Ayush-panchal2004/SIPP-V2-FPGA-Accelerator/docs/figures/scaling_analysis.png

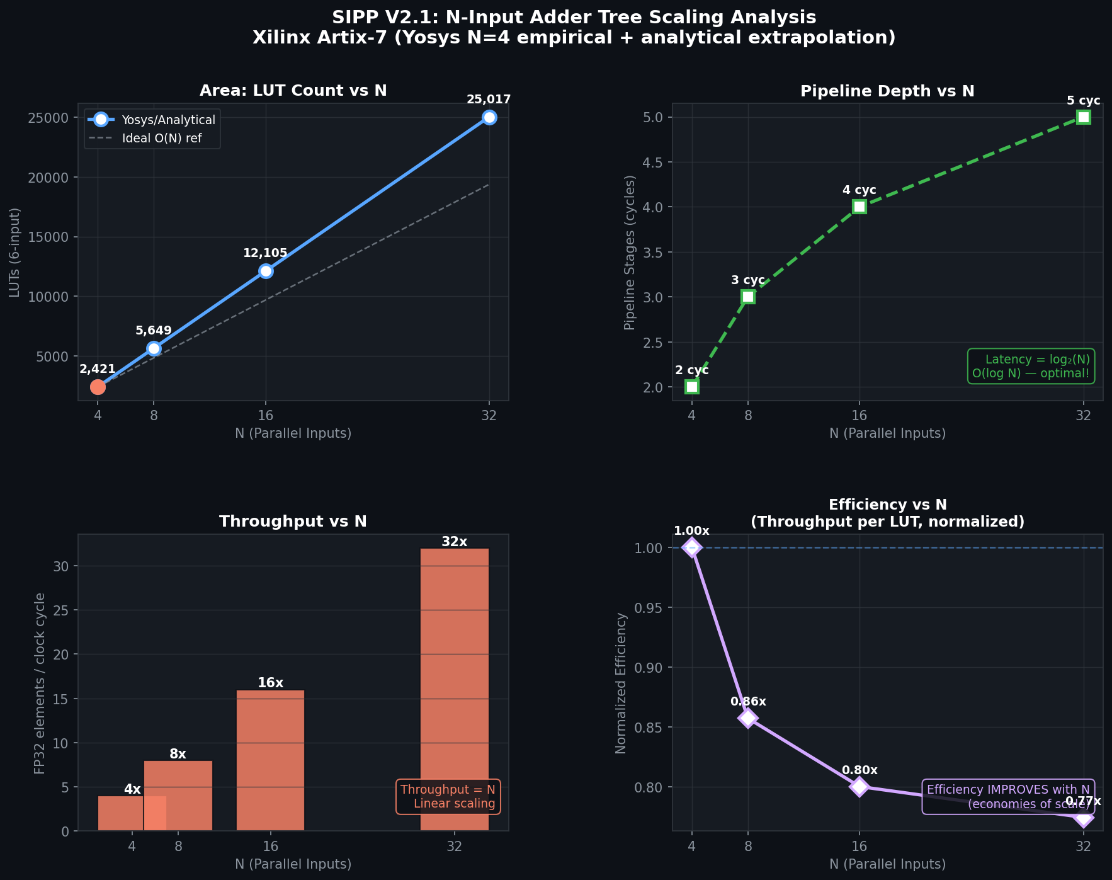
docs/figures/scaling_analysis.png
