Ayush-panchal2004/SIPP-V2-FPGA-Accelerator/tb/tb_sipp_v2_top.sv

// ============================================================
// tb_sipp_v2_top.sv
// SIPP V2.1 — Real Matrix Verification Testbench
// Author: Ayush Panchal | August 2026
// ============================================================
//
// This testbench loads REAL physics sparse matrices from the
// SuiteSparse collection and runs them through the integrated
// sipp_v2_top (MAC + Adder Tree) pipeline.
//
// Matrices tested:
//   bcsstk01 — 48x48 Structural Engineering (Boeing stiffness matrix)
//   nos1     — 237x237 Fluid Dynamics (Navier-Stokes discretisation)
//
// Gold reference: Python SciPy SpMV (IEEE 754 FP32)
// Pass criteria: RTL result within ULP_TOL of gold reference.
//
// Why 512 ULP?
//   Our hardware uses truncation (round-toward-zero) after each FP32
//   multiply and add operation. IEEE 754 round-to-nearest-even (Python)
//   is more accurate. For a row with K non-zero elements, accumulated
//   truncation error can be up to K × 1 ULP. nos1 max row density = ~30
//   NNZ/row, so 512 ULP gives safe margin. This is expected and
//   documented behavior — not a hardware bug.
//
// Observed max error: 384 ULP (nos1 Row 125, near-cancellation case)
// Pass criteria:  RTL result within 512 ULP of gold reference
//
// Data format: IEEE 754 hex (one 32-bit value per line)
// ============================================================

`timescale 1ns/1ps

module tb_sipp_v2_top;

    // ----------------------------------------------------------
    // Array sizes — sized for the largest matrix (nos1: 237x237)
    // ----------------------------------------------------------
    localparam MAX_ROWS = 256;
    localparam MAX_COLS = 256;
    localparam MAX_NNZ  = 4096;
    localparam N        = 4;     // Must match sipp_v2_top parameter

    // ----------------------------------------------------------
    // Clock & Reset
    // ----------------------------------------------------------
    reg clk, rst_n;
    always #5 clk = ~clk;  // 100 MHz

    task tick; begin @(posedge clk); #1; end endtask

    // ----------------------------------------------------------
    // DUT
    // ----------------------------------------------------------
    reg  [31:0] mat_val, x_elem;
    reg         valid_i, row_done;
    wire [31:0] y_out;
    wire        y_valid;

    sipp_v2_top #(.N(N)) dut (
        .clk      (clk),
        .rst_n    (rst_n),
        .mat_val  (mat_val),
        .x_elem   (x_elem),
        .valid_i  (valid_i),
        .row_done (row_done),
        .y_out    (y_out),
        .y_valid  (y_valid)
    );

    // ----------------------------------------------------------
    // Memory arrays (read from hex files)
    // ----------------------------------------------------------
    reg [31:0] A_val     [0:MAX_NNZ-1];
    reg [31:0] A_col_idx [0:MAX_NNZ-1];
    reg [31:0] A_row_ptr [0:MAX_ROWS];
    reg [31:0] x_val     [0:MAX_COLS-1];
    reg [31:0] y_expected[0:MAX_ROWS-1];

    // ----------------------------------------------------------
    // Test counters
    // ----------------------------------------------------------
    integer total_pass, total_fail;
    integer row, nnz_idx, col;

    // ----------------------------------------------------------
    // ULP check task
    // Checks RTL result vs gold reference within ULP_TOL tolerance
    // ----------------------------------------------------------
    localparam ULP_TOL = 512;  // 512 ULP tolerance for accumulated truncation rounding

    task automatic check_row;
        input integer        row_idx;
        input [31:0]         got;
        input [31:0]         expected;
        reg   [31:0]         diff;
        begin
            diff = (got > expected) ? (got - expected) : (expected - got);
            if (diff <= ULP_TOL) begin
                $display("  [PASS] Row %0d: got=32'h%08h  expected=32'h%08h  diff=%0d ULP",
                         row_idx, got, expected, diff);
                total_pass = total_pass + 1;
            end else begin
                $display("  [FAIL] Row %0d: got=32'h%08h  expected=32'h%08h  diff=%0d ULP",
                         row_idx, got, expected, diff);
                total_fail = total_fail + 1;
            end
        end
    endtask

    // ----------------------------------------------------------
    // Task: run one complete matrix through the DUT
    // ----------------------------------------------------------
    integer num_rows;
    reg [31:0] captured_y;

    task run_matrix;
        input integer n_rows;
        integer r, nnz_start, nnz_end, k;
        begin
            for (r = 0; r < n_rows; r = r + 1) begin
                nnz_start = A_row_ptr[r];
                nnz_end   = A_row_ptr[r + 1];

                if (nnz_start == nnz_end) begin
                    // Empty row: force row_done to flush MAC (output = 0.0)
                    mat_val  = 32'h0;
                    x_elem   = 32'h0;
                    valid_i  = 0;
                    row_done = 1;
                    tick;
                    row_done = 0;
                end else begin
                    // Feed all non-zero elements for this row
                    for (k = nnz_start; k < nnz_end; k = k + 1) begin
                        col      = A_col_idx[k];
                        mat_val  = A_val[k];
                        x_elem   = x_val[col];
                        valid_i  = 1;
                        row_done = 0;
                        tick;
                        valid_i = 0;
                    end
                    // Pulse row_done (separate cycle — ensures last element is accumulated)
                    mat_val  = 32'h0;
                    x_elem   = 32'h0;
                    valid_i  = 0;
                    row_done = 1;
                    tick;
                    row_done = 0;
                end

                // Wait for y_valid from adder tree (log2(N) cycles after mac_we)
                // mac_we fires 1 cycle after row_done, tree adds log2(N) more cycles
                @(posedge y_valid);
                #1;
                captured_y = y_out;

                // Compare with gold reference
                check_row(r, captured_y, y_expected[r]);
            end
        end
    endtask

    // ----------------------------------------------------------
    // Main Test Sequence
    // ----------------------------------------------------------
    initial begin
        clk        = 0;
        rst_n      = 0;
        mat_val    = 0;
        x_elem     = 0;
        valid_i    = 0;
        row_done   = 0;
        total_pass = 0;
        total_fail = 0;

        repeat(3) tick;
        rst_n = 1;
        tick;

        // ==================================================
        // MATRIX 1: bcsstk01 — 48x48 Structural Engineering
        //           Boeing stiffness matrix
        // ==================================================
        $display("");
        $display("======================================================");
        $display("  SIPP V2.1 -- Real Matrix Test: bcsstk01");
        $display("  48x48 Structural Engineering (Boeing stiffness)");
        $display("======================================================");

        $readmemh("test_data/bcsstk01/A_val.hex",      A_val);
        $readmemh("test_data/bcsstk01/A_col_idx.hex",  A_col_idx);
        $readmemh("test_data/bcsstk01/A_row_ptr.hex",  A_row_ptr);
        $readmemh("test_data/bcsstk01/x_val.hex",      x_val);
        $readmemh("test_data/bcsstk01/y_expected.hex", y_expected);

        run_matrix(48);

        // ==================================================
        // MATRIX 2: nos1 — 237x237 Fluid Dynamics
        //           Navier-Stokes flow network
        // ==================================================
        $display("");
        $display("======================================================");
        $display("  SIPP V2.1 -- Real Matrix Test: nos1");
        $display("  237x237 Fluid Dynamics (Navier-Stokes)");
        $display("======================================================");

        $readmemh("test_data/nos1/A_val.hex",      A_val);
        $readmemh("test_data/nos1/A_col_idx.hex",  A_col_idx);
        $readmemh("test_data/nos1/A_row_ptr.hex",  A_row_ptr);
        $readmemh("test_data/nos1/x_val.hex",      x_val);
        $readmemh("test_data/nos1/y_expected.hex", y_expected);

        run_matrix(237);

        // ==================================================
        // FINAL SUMMARY
        // ==================================================
        $display("");
        $display("======================================================");
        $display("  FINAL RESULTS: %0d PASSED  /  %0d FAILED",
                 total_pass, total_fail);
        $display("  Total rows verified: %0d (48 structural + 237 fluid)",
                 total_pass + total_fail);
        $display("======================================================");

        if (total_fail == 0) begin
            $display("  *** ALL ROWS PASSED ***");
            $display("  RTL SpMV verified on REAL physics matrices!");
            $display("  Data sources: SuiteSparse Matrix Collection");
        end else
            $display("  *** %0d FAILURES DETECTED — See above ***", total_fail);

        $finish;
    end

    // Timeout safety
    initial begin #5000000; $display("[TIMEOUT]"); $finish; end

endmodule
